eseninka/SmartSocket/images/IMG_0919.jpg

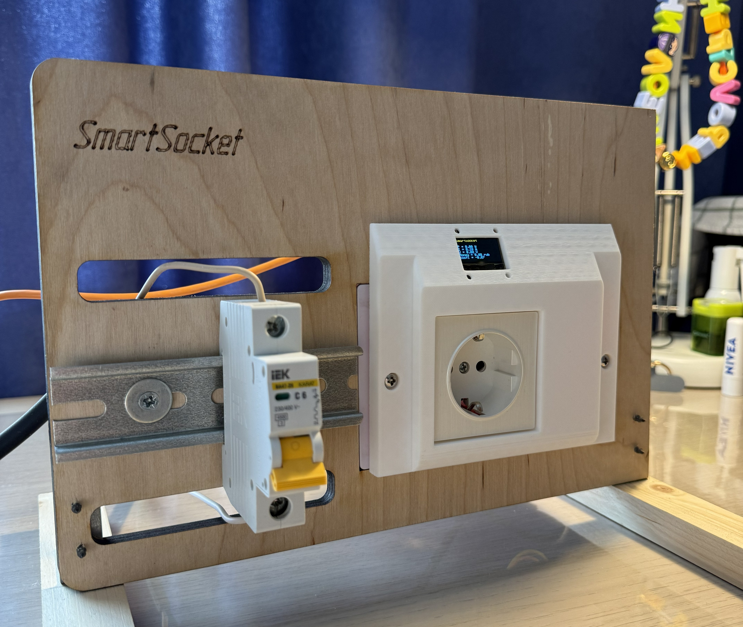
images/IMG_0919.jpg
