eseninka/SmartSocket/images/IMG_0915.JPG

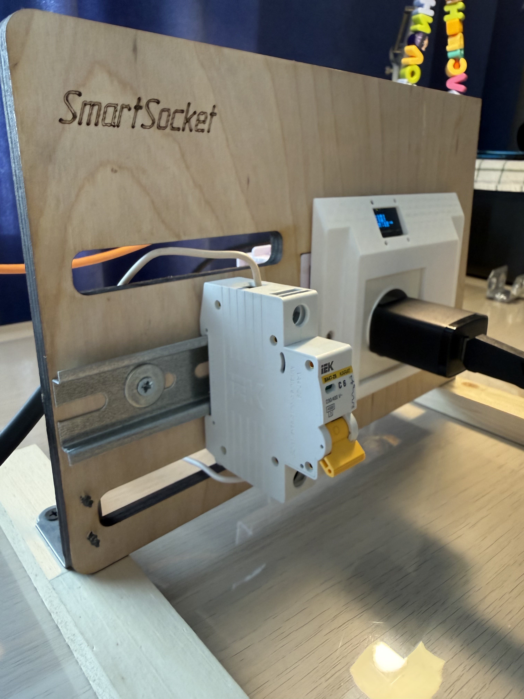
images/IMG_0915.JPG
