eseninka/SmartSocket/videoAndPresentation/SmartSocketV2(для конференции ИТ-прорыв)_1.pdf

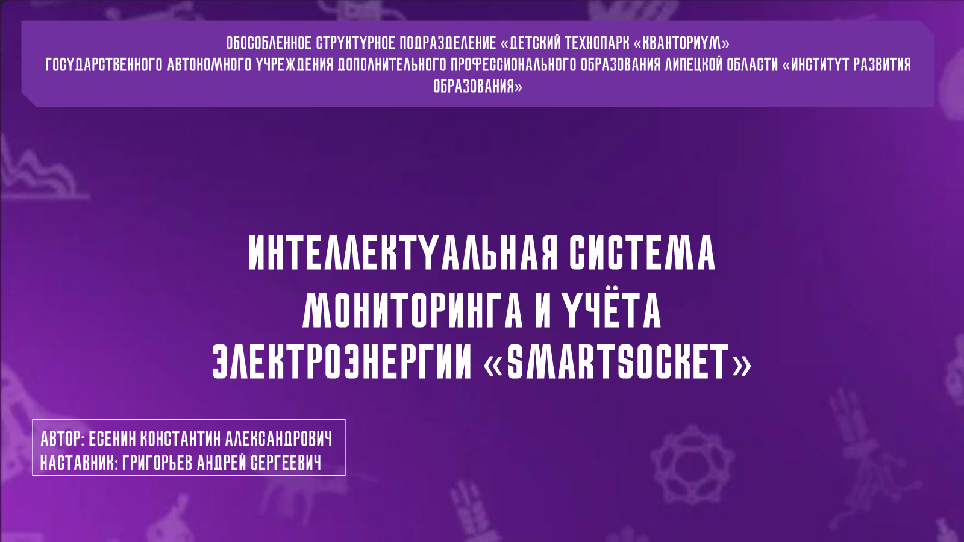
[picture p3: page 1]

« | »
« | « | »
«
»

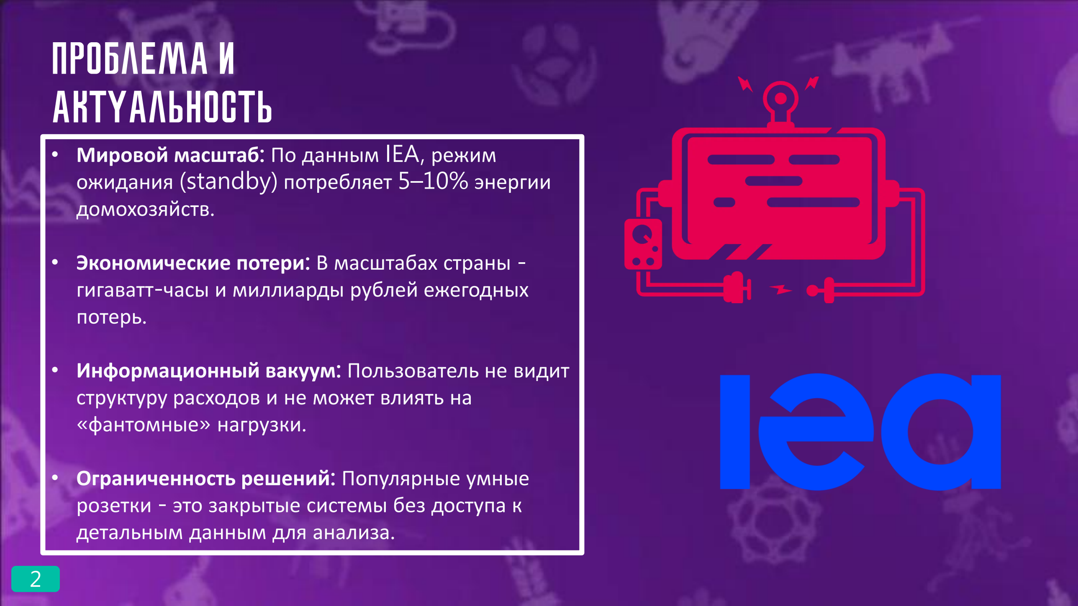
[picture p4: page 2]

- Мировой масштаб: По данным IEA, режим ожидания (standby) потребляет 5–10% энергии домохозяйств.
- Экономические потери: В масштабах страны -гигаватт-часы и миллиарды рублей ежегодных потерь.
- Информационный вакуум: Пользователь не видит структуру расходов и не может влиять на «фантомные» нагрузки.
- Ограниченность решений: Популярные умные розетки - это закрытые системы без доступа к детальным данным для анализа.

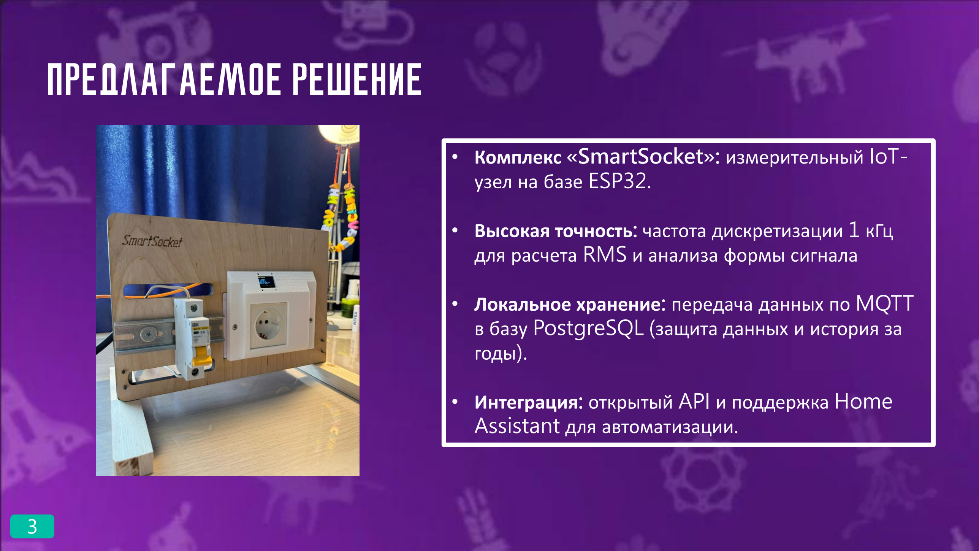
[picture p5: page 3]

- Комплекс «SmartSocket»: измерительный IoT-узел на базе ESP32.
- Высокая точность: частота дискретизации 1 кГц для расчета RMS и анализа формы сигнала
- Локальное хранение: передача данных по MQTT в базу PostgreSQL (защита данных и история за годы).
- Интеграция: открытый API и поддержка Home Assistant для автоматизации.

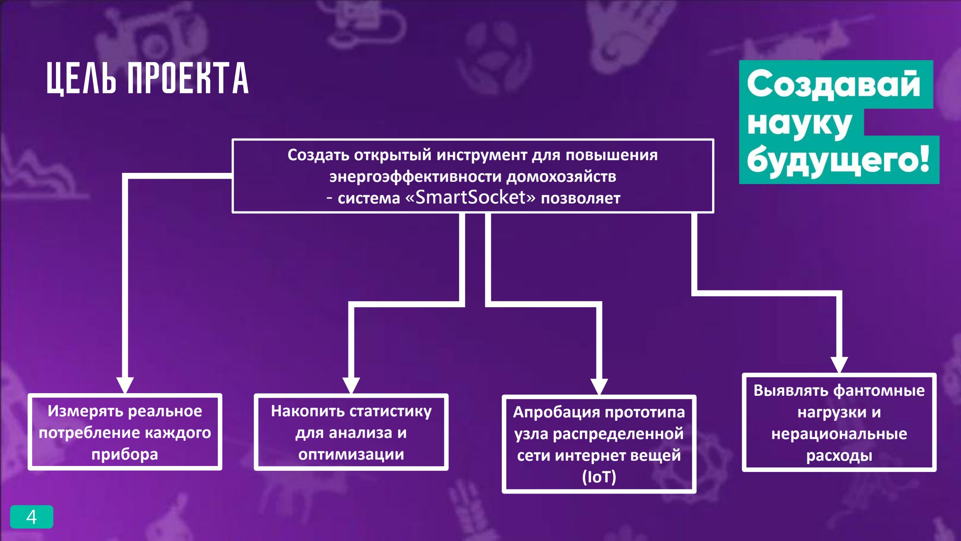
[picture p6: page 4]

Измерять реальное
потребление каждого
прибора

Выявлять фантомные
нагрузки и
нерациональные
расходы

Накопить статистику
для анализа и
оптимизации

Апробация прототипа
узла распределенной
сети интернет вещей
(IoT)

Создать открытый инструмент для повышения энергоэффективности домохозяйств
- система «SmartSocket» позволяет

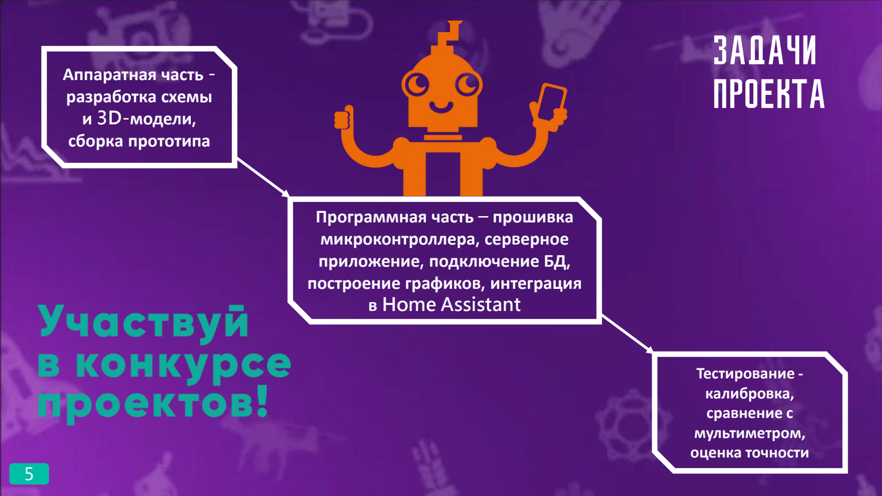
[picture p7: page 5]

Программная часть – прошивка микроконтроллера, серверное приложение, подключение БД, построение графиков, интеграция в Home Assistant

Аппаратная часть -
разработка схемы
и 3D-модели,
сборка прототипа

Тестирование -
калибровка,
сравнение с
мультиметром,
оценка точности

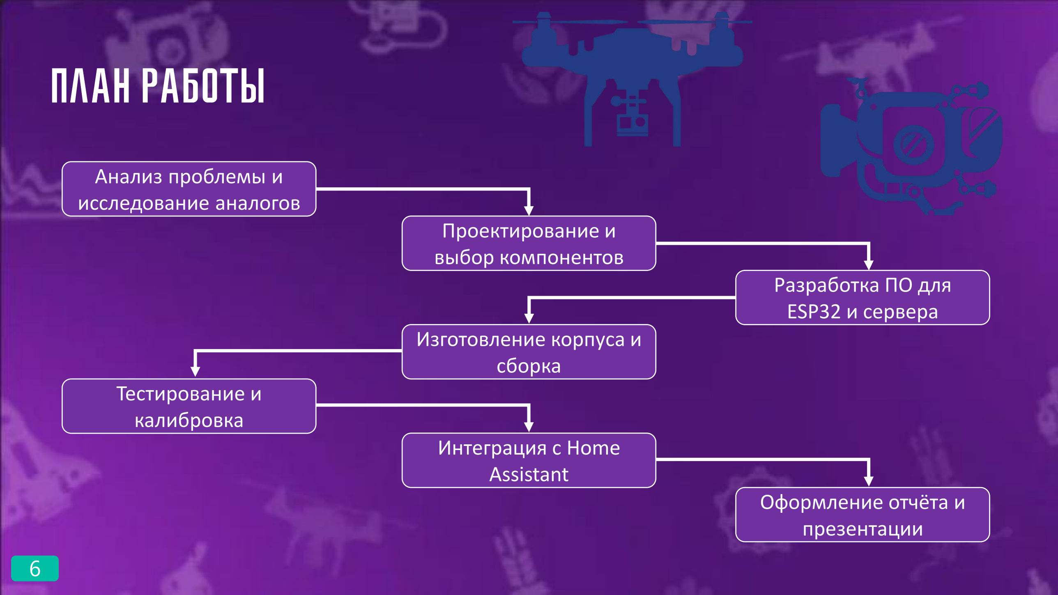
[picture p8: page 6]

Анализ проблемы и
исследование аналогов
Проектирование и
выбор компонентов
Разработка ПО для
ESP32 и сервера
Изготовление корпуса и
сборка
Тестирование и
калибровка
Интеграция с Home
Assistant
Оформление отчёта и
презентации

Модель | Измерения | Локальный дисплей | Интеграция с HA | Открытость | Возможности для энергоанализа
Xiaomi Mi Smart Plug 2 | Только мощность | Нет | Через сторонний софт | Закрытый | Минимальные
SONOFF S31 | Ток, напряжение, мощность, суточный лог | Нет | Через прошивки | Закрытый, но есть прошивки | Базовый лог
TP-Link Tapo | Есть (детали не указаны) | Нет | Официальная | Закрытый | Ограниченный
SmartSocket | Ток, напряжение, мощность, энергия, cos φ, 20 мгновенных значений | OLED 128×64 | Нативная | Полностью открытый | Глубокая аналитика, PostgreSQL, графики

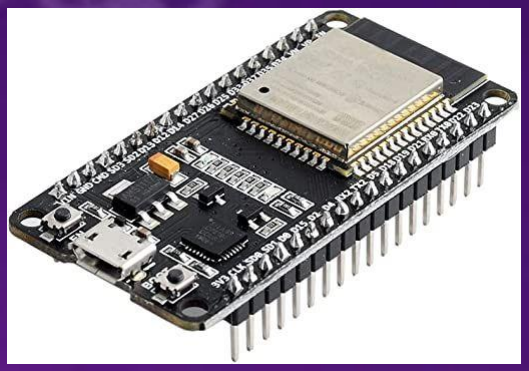
[picture p9: figure]

ESP32 - Wi-Fi, 12-бит АЦП

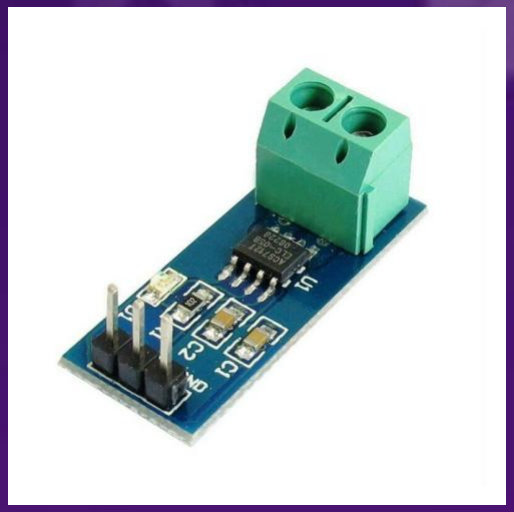
[picture p10: figure]
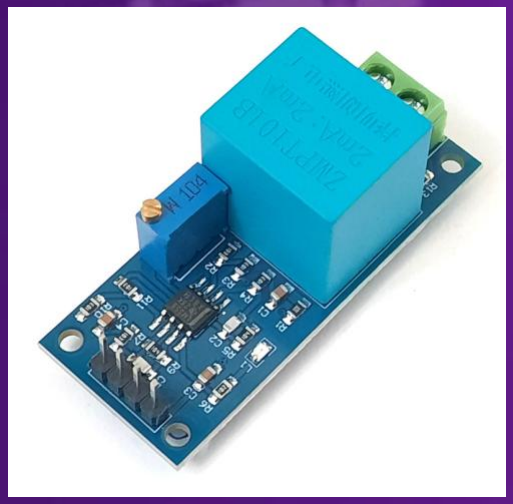
[picture p11: figure]

ACS712 (5А) и ZMPT101B - оптимальны по цене/точности

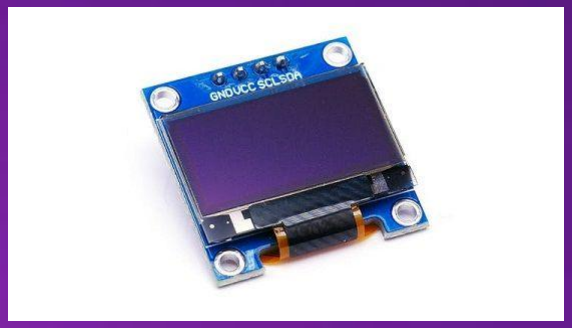
[picture p12: figure]

OLED SSD1306 — локальный
вывод параметров

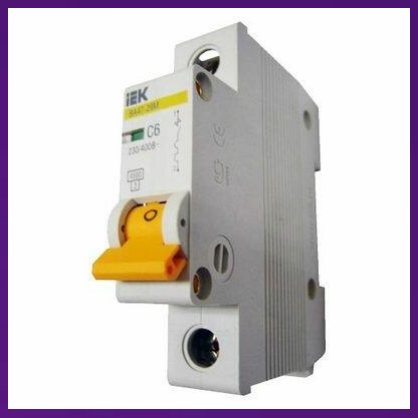
[picture p13: figure]

Автоматический
выключатель 6А — защита

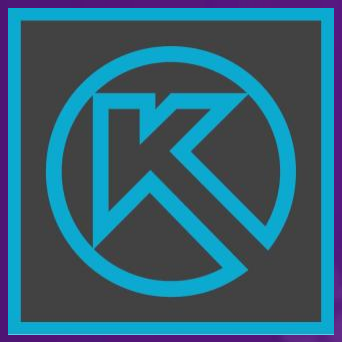
[picture p14: figure]

Корпус — 3D-печать,
подрозетник

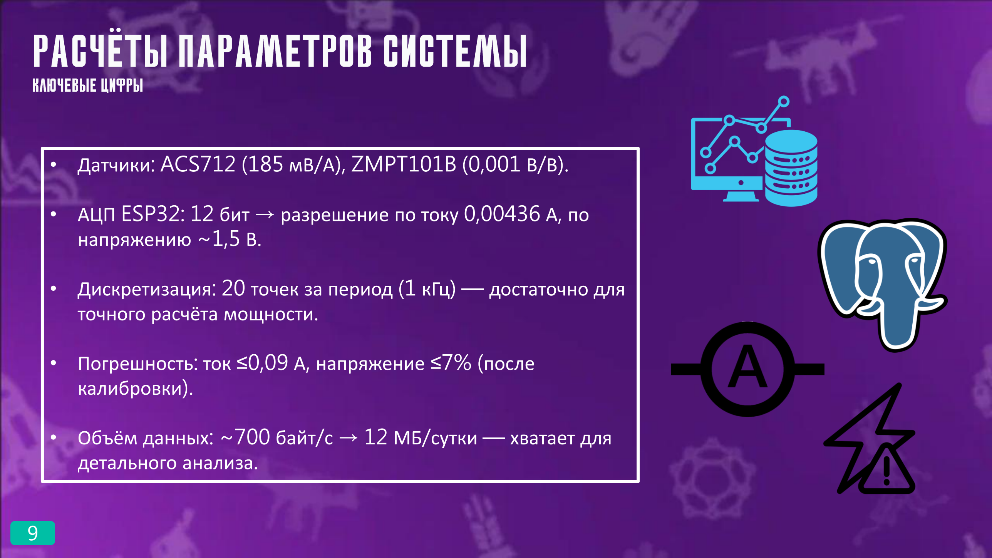
[picture p15: page 9]

- Датчики: ACS712 (185 мВ/А), ZMPT101B (0,001 В/В).
- АЦП ESP32: 12 бит → разрешение по току 0,00436 А, по напряжению ~1,5 В.
- Дискретизация: 20 точек за период (1 кГц) — достаточно для точного расчёта мощности.
- Погрешность: ток ≤0,09 А, напряжение ≤7% (после калибровки).
- Объём данных: ~700 байт/с → 12 МБ/сутки — хватает для детального анализа.

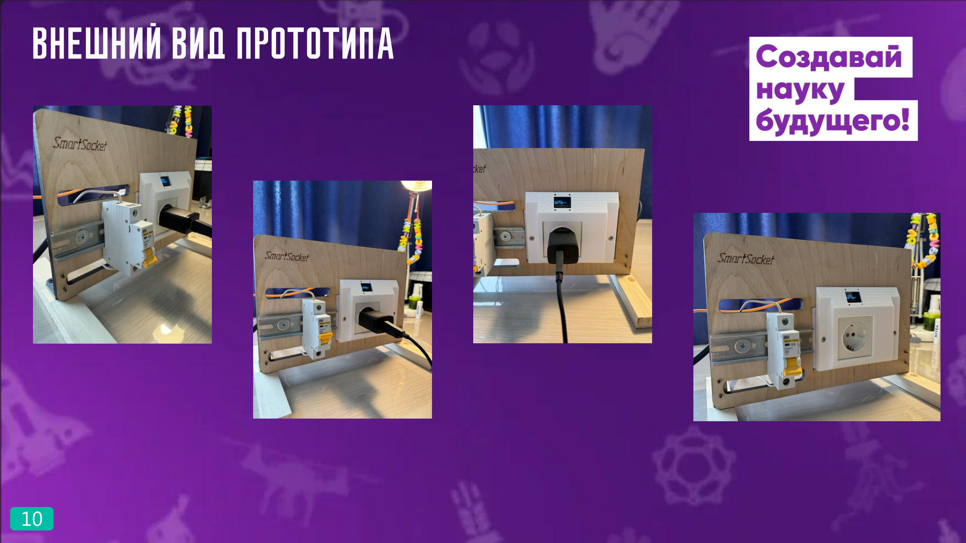
[picture p16: page 10]
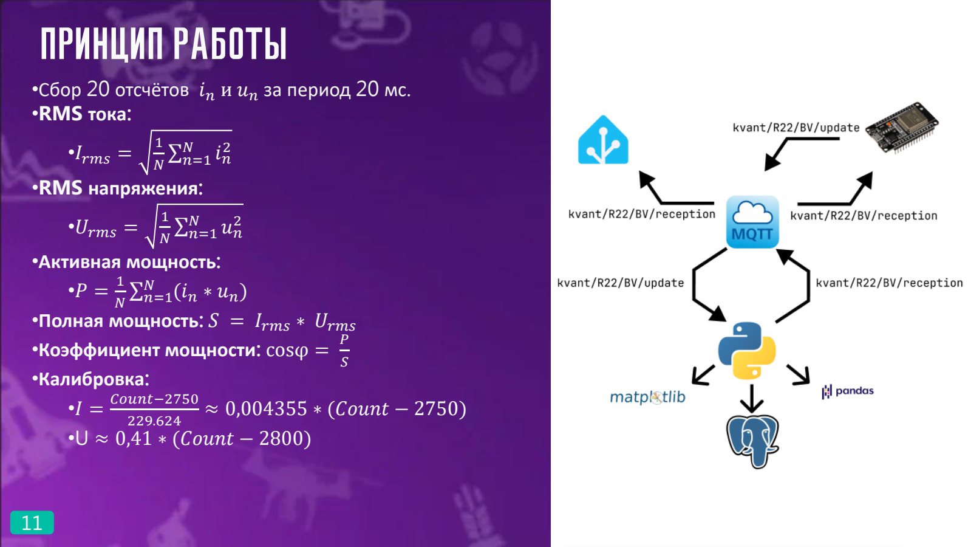
[picture p17: page 11]

•Сбор 20 отсчётов in и un за период 20 мс. •RMS тока:

•Irms =

1
N

σn=1

N in

2

•RMS напряжения:

•Urms =

1
N

σn=1

N un

2

•Активная мощность:
•P =

1
N

σn=1

N (in ∗ un)
•Полная мощность: S = Irms ∗ Urms •Коэффициент мощности: cosφ =

P
S
•Калибровка:
•I =

Count−2750
229.624

≈ 0,004355 ∗ (Count − 2750) •U ≈ 0,41 ∗ (Count − 2800)

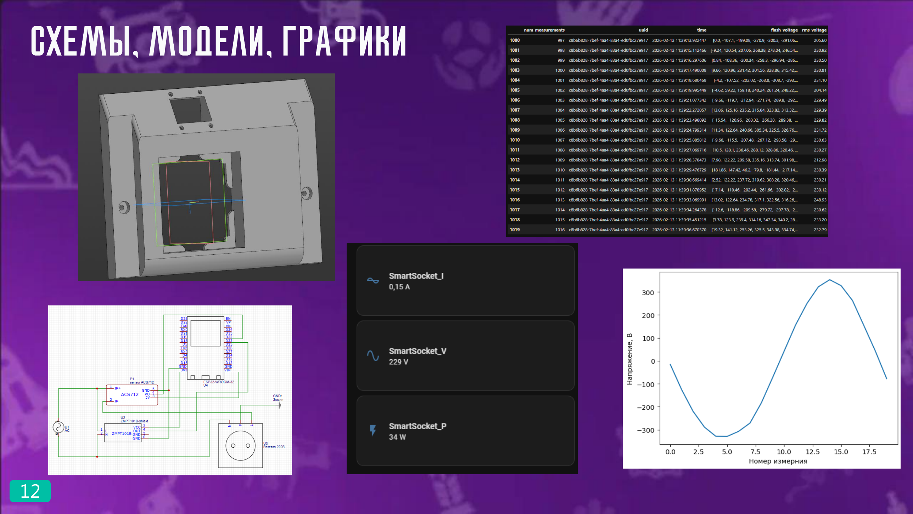
[picture p18: page 12]

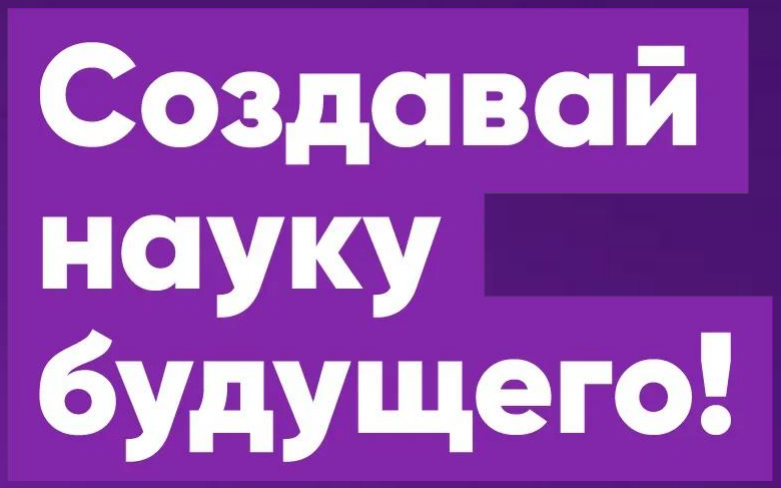
[picture p19: figure]

•✅Работающий прототип собран.

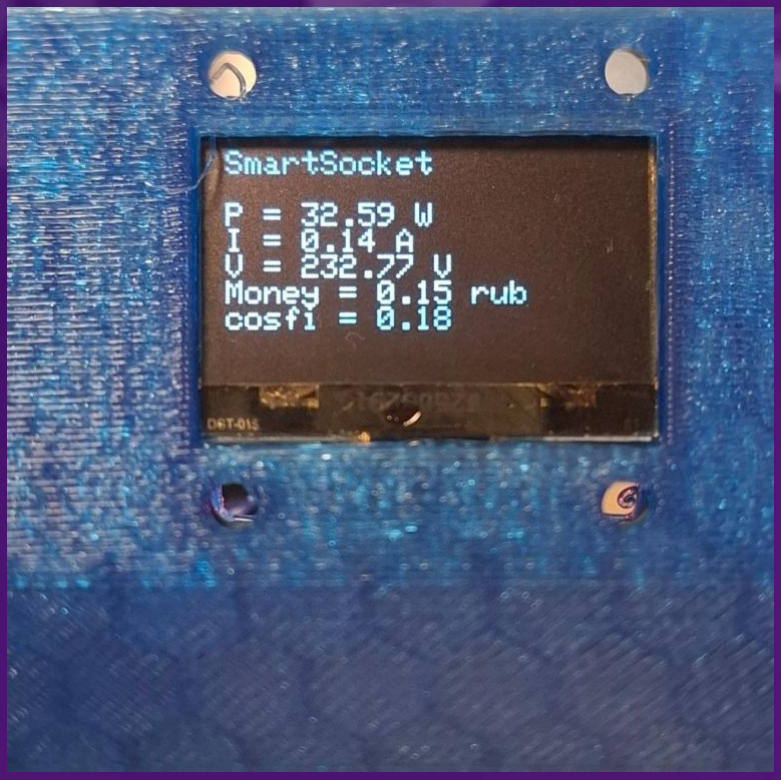
[picture p20: figure]

•✅Точность подтверждена мультиметром: ток ±0,09 А, напряжение ±2%. •✅Данные сохраняются в PostgreSQL и доступны в Home Assistant. •✅Стабильная работа в течение суток, потерь нет.
•✅Все материалы открыты на GitHub.

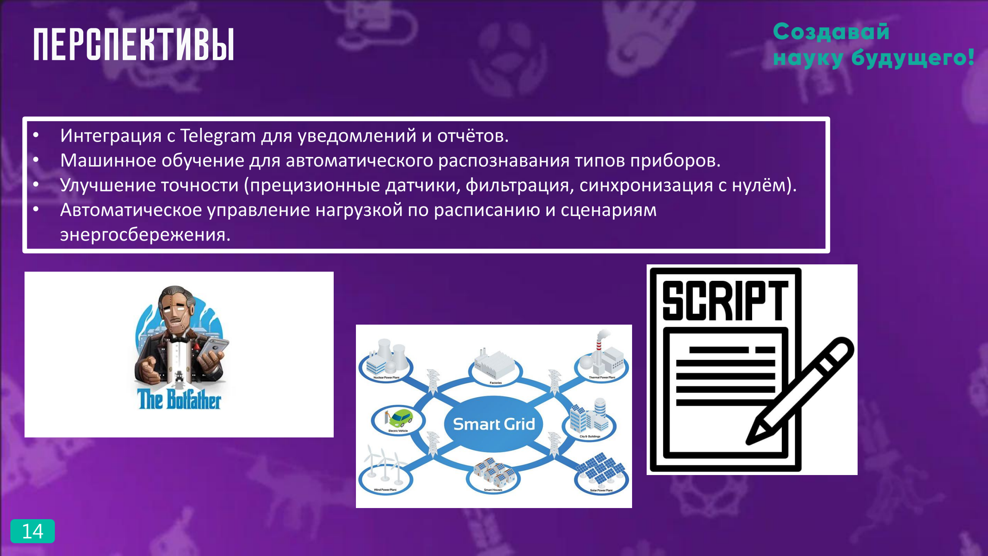
[picture p21: page 14]

- Интеграция с Telegram для уведомлений и отчётов.
- Машинное обучение для автоматического распознавания типов приборов.
- Улучшение точности (прецизионные датчики, фильтрация, синхронизация с нулём).
- Автоматическое управление нагрузкой по расписанию и сценариям энергосбережения.

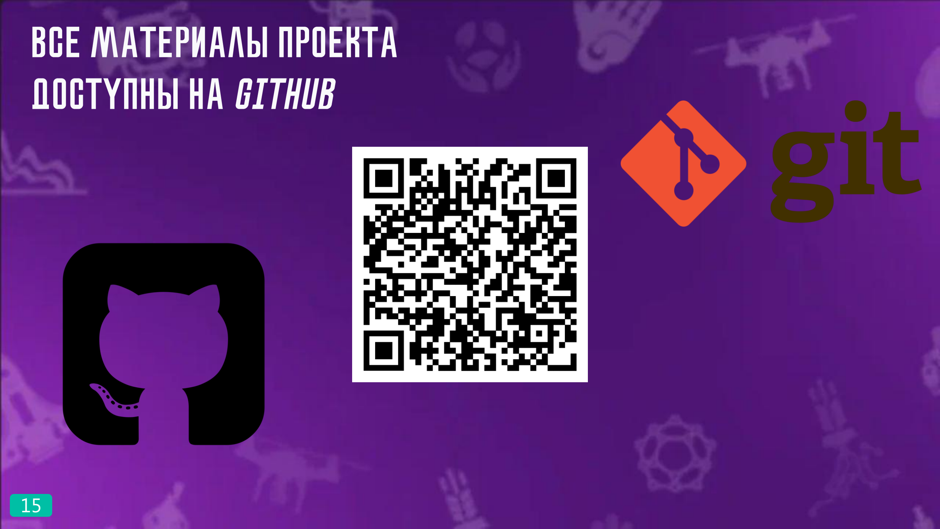
[picture p22: page 15]
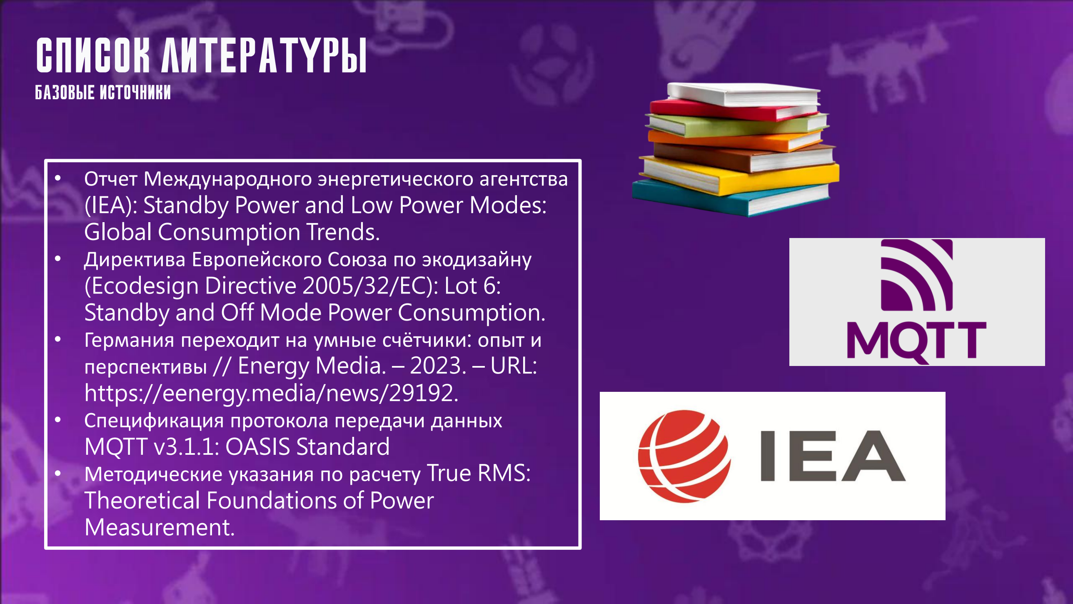
[picture p23: page 16]

- Отчет Международного энергетического агентства (IEA): Standby Power and Low Power Modes: Global Consumption Trends.
- Директива Европейского Союза по экодизайну (Ecodesign Directive 2005/32/EC): Lot 6: Standby and Off Mode Power Consumption.
- Германия переходит на умные счётчики: опыт и перспективы // Energy Media. – 2023. – URL: https://eenergy.media/news/29192.
- Спецификация протокола передачи данных MQTT v3.1.1: OASIS Standard
- Методические указания по расчету True RMS: Theoretical Foundations of Power Measurement.
