eseninka/SmartSocket/images/принцип общения с сервером.png

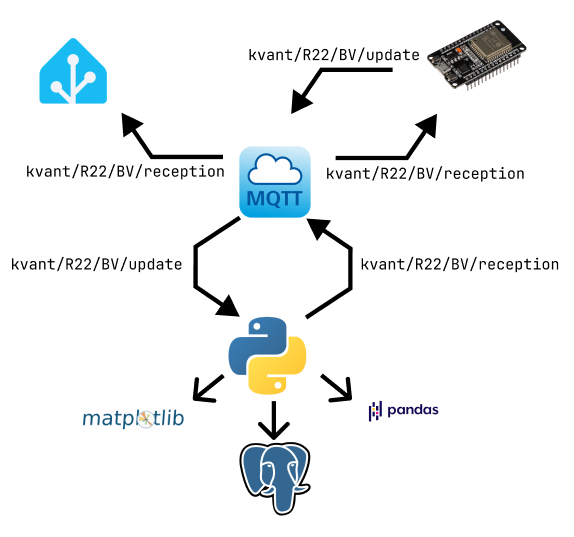
images/принцип общения с сервером.png
