eseninka/SmartSocket/images/Снимок экрана 2026-02-16 210238.png

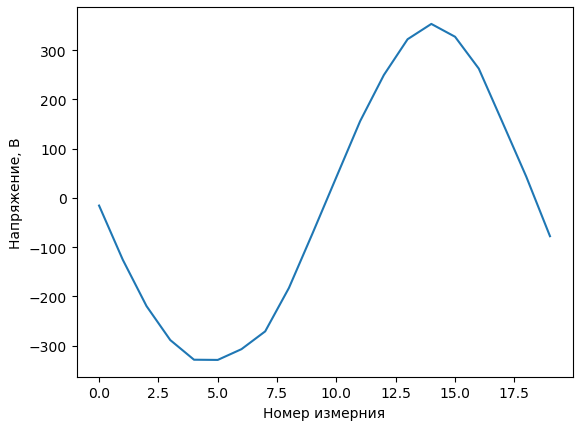
images/Снимок экрана 2026-02-16 210238.png
