eseninka/SmartSocket/images/Снимок экрана 2026-02-16 210535.png

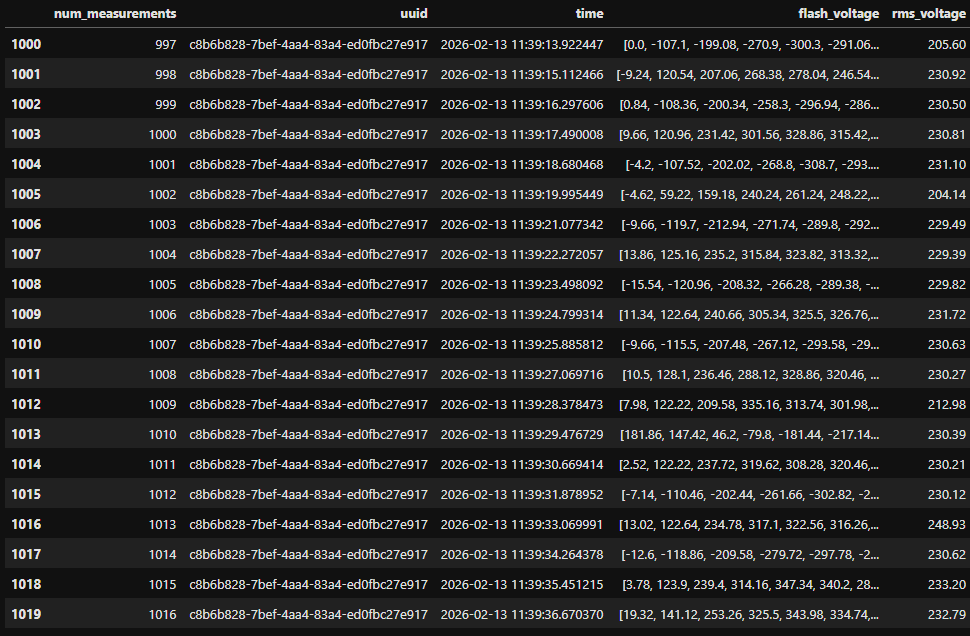
images/Снимок экрана 2026-02-16 210535.png
