eseninka/SmartSocket/scheme/Принципиальная схема устройства.png

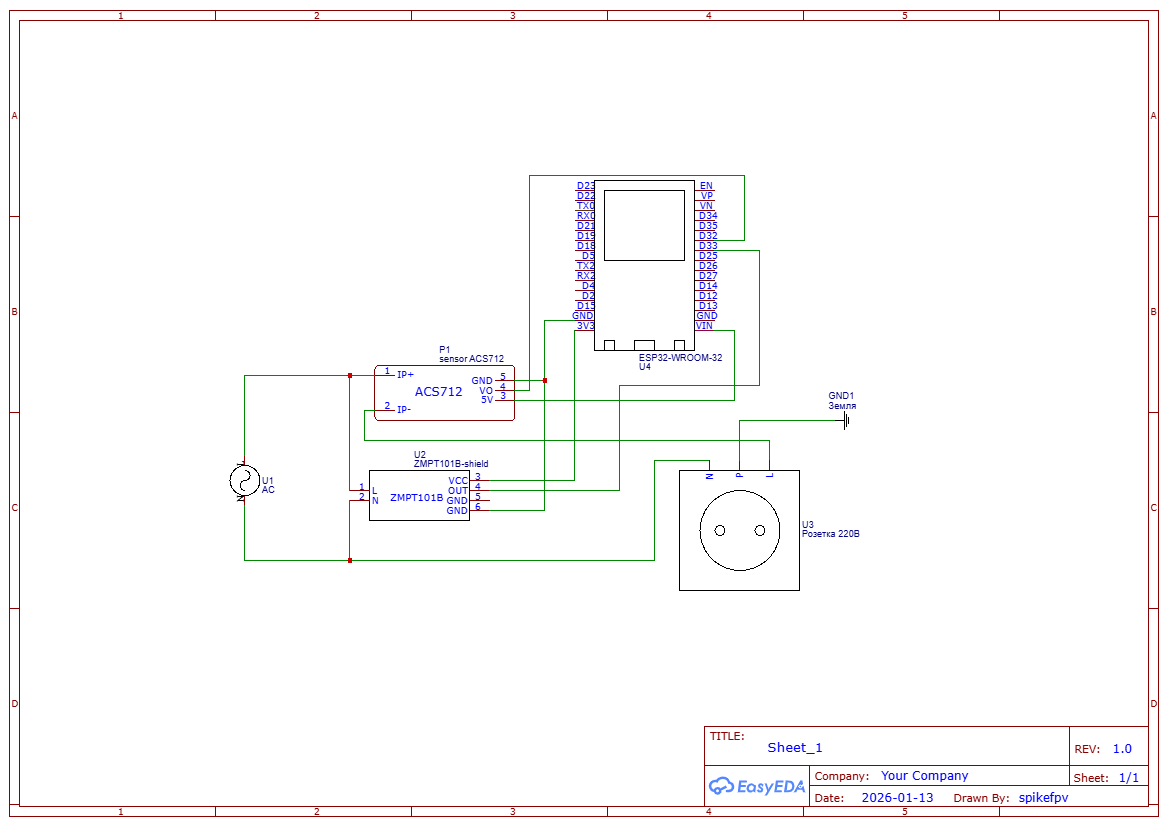
scheme/Принципиальная схема устройства.png
