eseninka/SmartSocket/(commit log)

2026-01-31 Create scheme
    Файл с принципиальными схемами
2026-02-07 unification curent and voltage read func
2026-02-07 add voltage table
2026-02-07 normal visual voltage/current
